sherwin-sattar/soldering-station_V1.1/Hardware/3D view/T12 soldering station V1.1(1).png

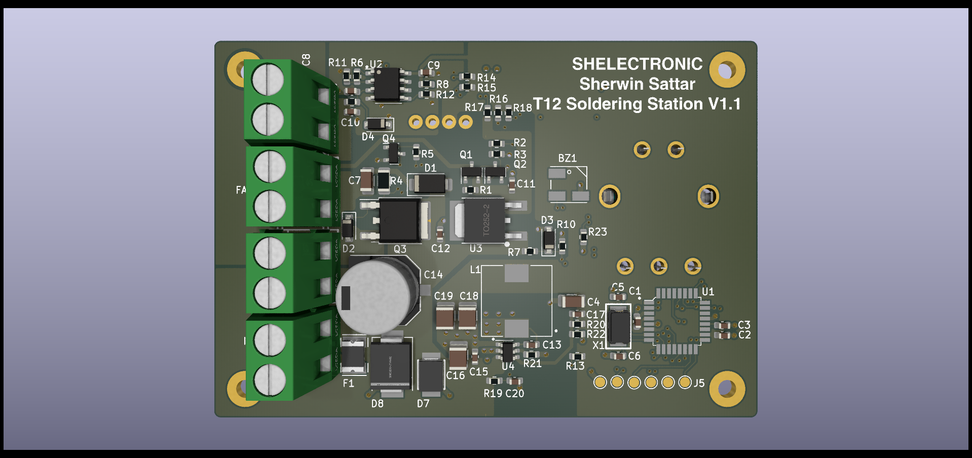
Hardware/3D view/T12 soldering station V1.1(1).png
