sherwin-sattar/soldering-station_V1.1/README.md

# Soldering Station V1.1
## 3D views
T12 soldering station V1 1(1)
T12 soldering station V1 1(2)
