sherwin-sattar/soldering-station_V1.1/Hardware/T12 soldering station.kicad_pcb

## KiCad design Hardware/T12 soldering station.kicad_pcb (2024-11-20)

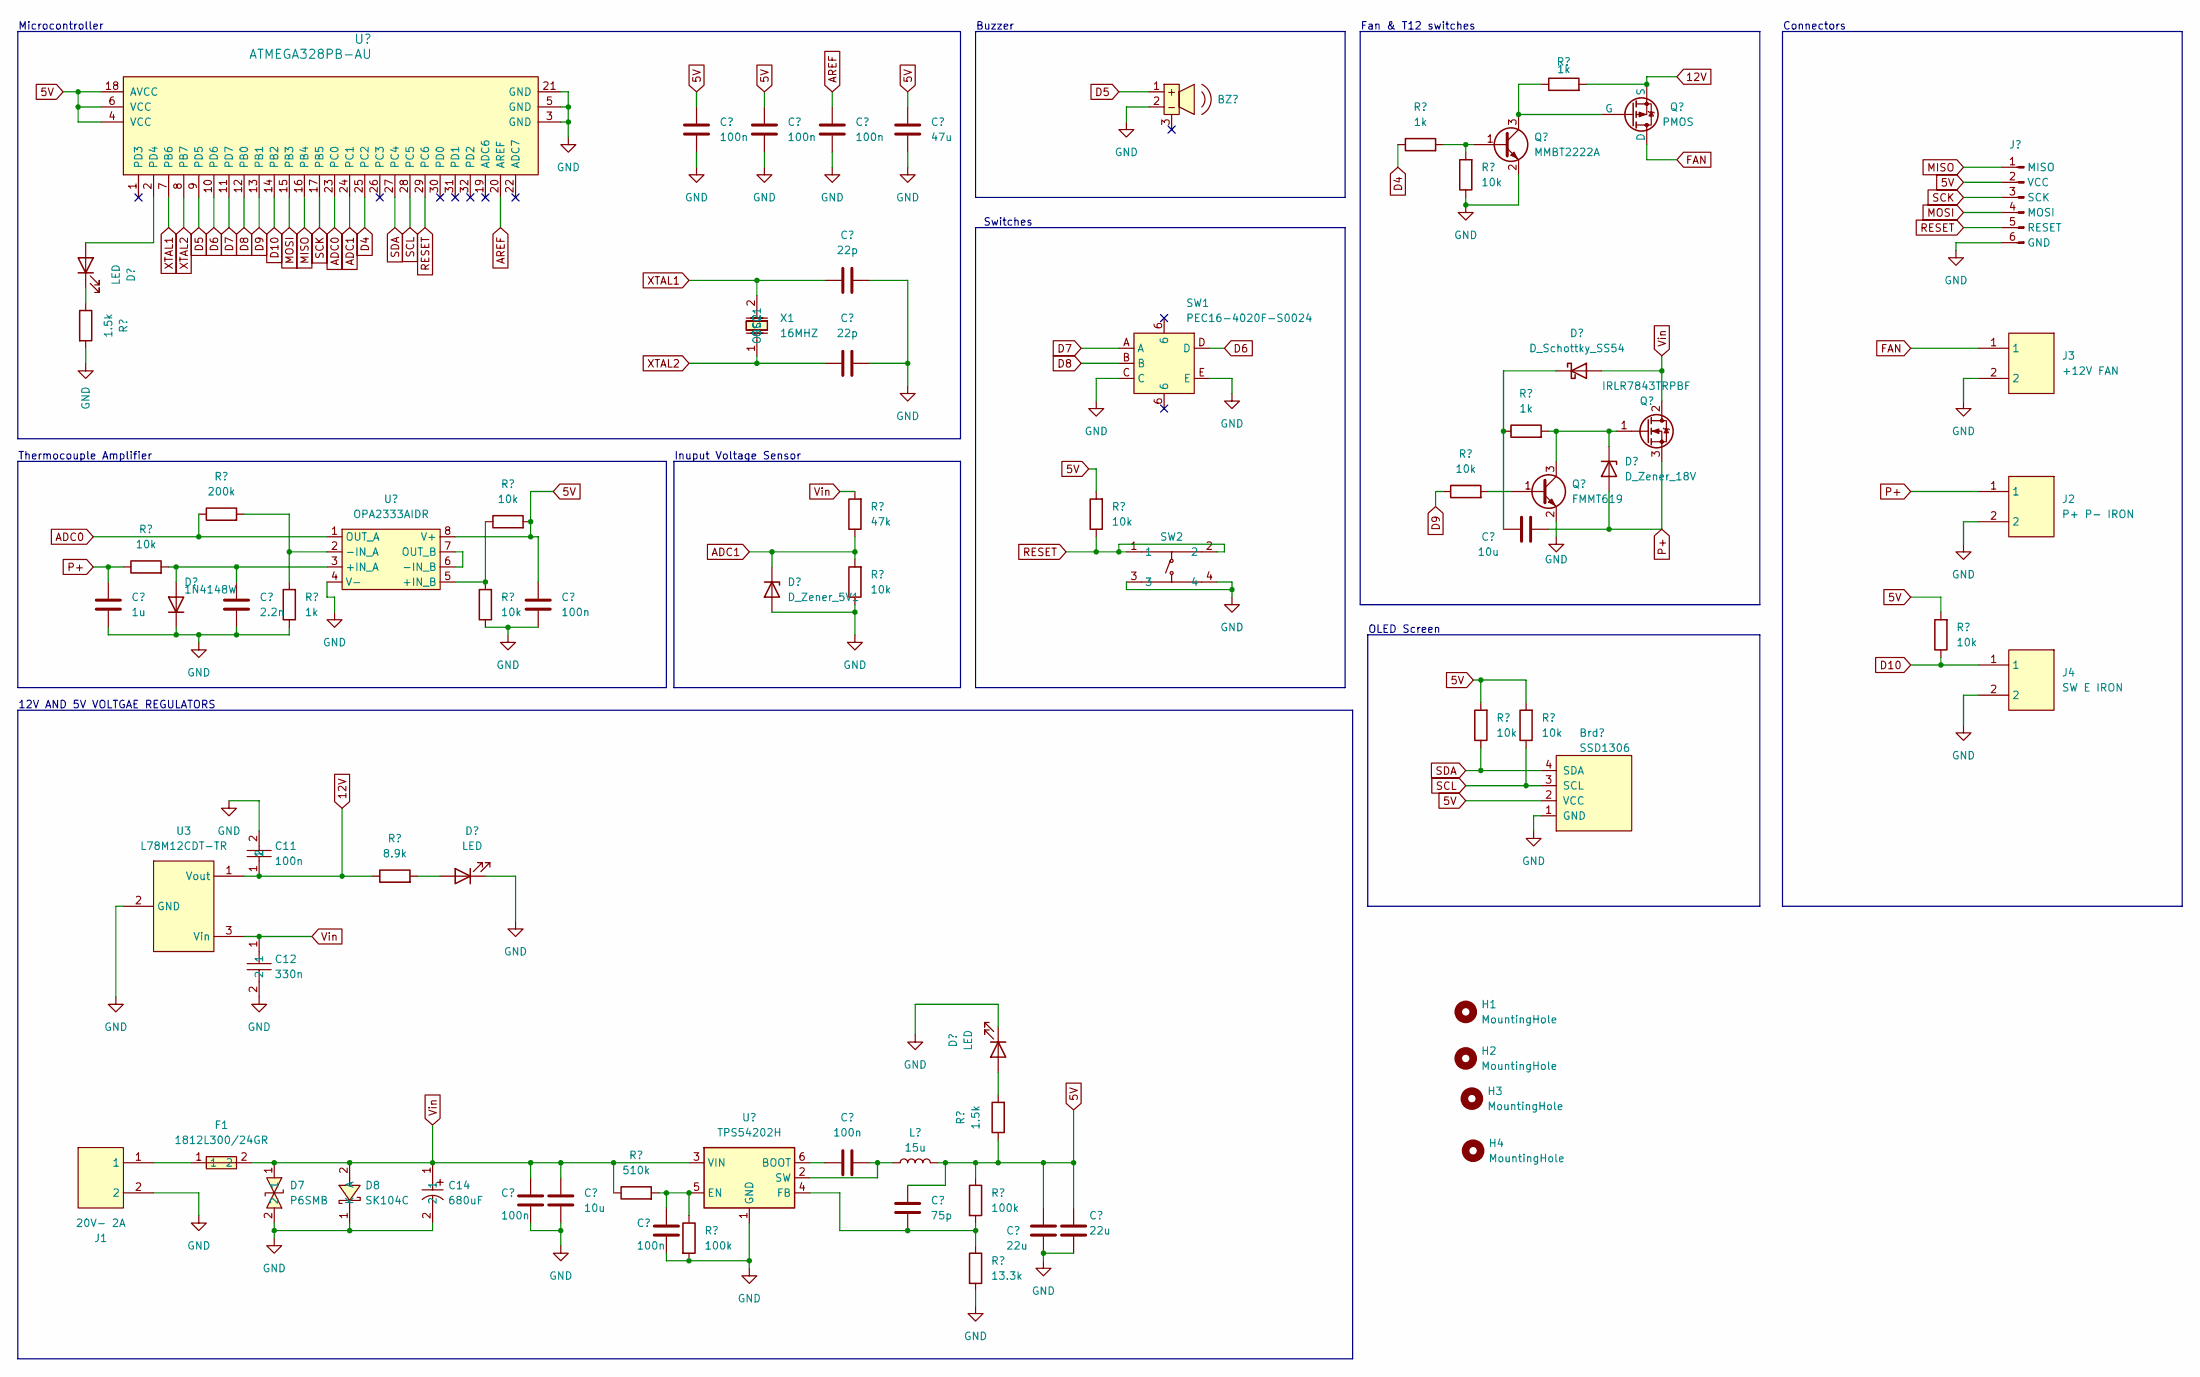
[picture p3: schematic T12 soldering station.kicad_sch, T12 soldering station-V2]

Parts:
BZ1: Buzzer; LCSC PN C95297
C1, C2, C3, C9, C11, C13, C15, C20: 100n; C_0603_1608Metric; LCSC PN C1590
C4: 47u; C_1206_3216Metric; LCSC PN C96123
C5, C6: 22p; C_0603_1608Metric; LCSC PN C1653
C7: 10u; C_1206_3216Metric; LCSC PN C92797
C8: 2.2n; C_0603_1608Metric; LCSC PN C16033
C10: 1u; C_0603_1608Metric; LCSC PN C15849
C12: 330n; C_0603_1608Metric; LCSC PN C694217
C14: 680uF; CAP-SMD_BD10.0-L10.3-W10.3-LS10.9-FD; LCSC PN C2980172
C16: 10u; C_1210_3225Metric; LCSC PN C1952589
C17: 75p; C_0603_1608Metric; LCSC PN C426100
C18, C19: 22u; C_1210_3225Metric; LCSC PN C21397
D1: D_Schottky_SS54; D_SMA; LCSC PN C123946
D2: D_Zener_18V; D_SOD-123; LCSC PN C116111
D3: D_Zener_5V1; D_SOD-123; LCSC PN C81601
D4: 1N4148W; D_SOD-123; LCSC PN C241939
D5, D6, D9: LED; LED_0603_1608Metric; LCSC PN C440519
D7: P6SMB; DO-214AA_L4.4-W3.6-LS5.3-BI; LCSC PN C776247
D8: SK104C; SMC_L6.9-W5.9-LS7.9-RD; LCSC PN C18199211
F1: 1812L300/24GR; F1812; LCSC PN C20627123
H1, H2, H3, H4: MountingHole; MountingHole_2.7mm_M2.5_Pad_TopBottom
J1: 20V- 2A; CONN-TH_2P-P5.00_WJ128V-5.0-2P; LCSC PN C8269
J2: P+ P- IRON; CONN-TH_2P-P5.00_WJ128V-5.0-2P; LCSC PN C8269
J3: +12V FAN; CONN-TH_2P-P5.00_WJ128V-5.0-2P; LCSC PN C8269
J4: SW E IRON; CONN-TH_2P-P5.00_WJ128V-5.0-2P; LCSC PN C8269
J5: ISP_1x6
L1: 15u; L_10.4x10.4_H4.8; LCSC PN C225048
LCD1: SSD1306; oled0.96_4pin; LCSC PN C5248080
Q1: PMOS; SOT-23; LCSC PN C15127
Q2: MMBT2222A; SOT-23; LCSC PN C194252
Q3: IRLR7843TRPBF; TO-252-2; LCSC PN C21988
Q4: FMMT619; SOT-23; LCSC PN C53071
R1, R2, R11: 1k; R_0603_1608Metric; LCSC PN C21190
R3, R5, R8, R9, R10, R12, R13, R14, R15, R16: 10k; R_0603_1608Metric; LCSC PN C25804
R4: 1k; R_1206_3216Metric; LCSC PN C4410
R6: 200k; R_0603_1608Metric; LCSC PN C25811
R7: 47k; R_0603_1608Metric; LCSC PN C25819
R17: 8.9k; R_0603_1608Metric; LCSC PN C5197519
R18, R23: 1.5k; R_0603_1608Metric; LCSC PN C22843
R19: 510k; R_0603_1608Metric; LCSC PN C843959
R20, R21: 100k; R_0603_1608Metric; LCSC PN C844916
R22: 13.3k; R_0603_1608Metric; LCSC PN C844126
SW1: PEC16-4020F-S0024; SW-TH_PEC16-4020F-S0024; LCSC PN C143803
SW2: PTS645SH50SMTR92LFS; KEY-SMD_4P-L6.0-W6.0-P4.50-LS9.0; LCSC PN C221869
U1: ATMEGA328PB-AU; TQFP-32_7x7mm; MPN ATMEGA328P-AU; Digi-Key_PN ATMEGA328P-AU-ND
U2: OPA2333AIDR; SOIC-8_3.9x4.9mm_P1.27mm; LCSC PN C38732
U3: L78M12CDT-TR; TO-252-2_L6.5-W6.1-P4.58-LS10.0-TL; LCSC PN C16424
U4: TPS54202H; SOT-23-6; LCSC PN C527684
X1: 16MHZ; OSC-SMD_L5.0-W3.2; LCSC PN C112572

Connections:
5V: C1.2, C2.2, C4.2, C9.2, C17.1, C18.1, C19.1, J5.2 (VCC), L1.2, LCD1.2 (VCC), R8.2, R13.2, R14.2, R15.2, R16.2, R18.1, R20.1, U1.4 (VCC), U1.6 (VCC), U1.18 (AVCC), U2.8 (V+)
12V: C11.1, Q1.2 (S), R1.2, R17.1, U3.1 (Vout)
ADC0: R6.1, U1.23 (PC0), U2.1 (OUT_A)
ADC1: D3.1 (K), R7.1, R10.2, U1.24 (PC1)
AREF: C3.2, U1.20 (AREF)
D4: R2.1, U1.25 (PC2)
D5: BZ1.1, U1.9 (PD5)
D6: SW1.D, U1.10 (PD6)
D7: SW1.A, U1.11 (PD7)
D8: SW1.B, U1.12 (PB0)
D9: R5.1, U1.13 (PB1)
D10: J4.1, R13.1, U1.14 (PB2)
FAN: J3.1, Q1.3 (D)
GND: BZ1.2, C1.1, C2.1, C3.1, C4.1, C5.1, C6.1, C8.1, C9.1, C10.1, C11.2, C12.2, C14.2, C15.2, C16.2, C18.2, C19.2, C20.2, D3.2 (A), D4.1 (K), D5.1 (K), D6.1 (K), D7.2, D8.1 (K), J1.2, J2.2, J3.2, J4.2, J5.6 (GND), LCD1.1 (GND), Q2.2 (E), Q4.2 (E), R3.1, R10.1, R11.1, R12.1, R21.2, R22.2, R23.2, SW1.C, SW1.E, SW2.3, SW2.4, U1.3 (GND), U1.5 (GND), U1.21 (GND), U2.4 (V-), U3.2 (GND), U4.1 (GND)
MISO: J5.1 (MISO), U1.16 (PB4)
MOSI: J5.4 (MOSI), U1.15 (PB3)
unnamed: C7.1, D1.1 (K), R4.1
unnamed: D2.1 (K), Q3.1 (G), Q4.3 (C), R4.2
unnamed: C8.2, D4.2 (A), R9.2, U2.3 (+IN_A)
unnamed: D5.2 (A), R17.2
unnamed: D6.2 (A), R18.2
unnamed: D9.2 (A), U1.2 (PD4)
unnamed: D9.1 (K), R23.1
unnamed: F1.1, J1.1
unnamed: Q1.1 (G), Q2.3 (C), R1.1
unnamed: Q2.1 (B), R2.2, R3.2
unnamed: Q4.1 (B), R5.2
unnamed: R8.1, R12.2, U2.5 (+IN_B)
unnamed: R6.2, R11.2, U2.2 (-IN_A)
unnamed: U2.6 (-IN_B), U2.7 (OUT_B)
unnamed: C13.1, U4.6 (BOOT)
unnamed: C20.1, R19.2, R21.1, U4.5 (EN)
unnamed: C17.2, R20.2, R22.1, U4.4 (FB)
unnamed: C13.2, L1.1, U4.2 (SW)
P+: C7.2, C10.2, D2.2 (A), J2.1, Q3.3 (S), R9.1
RESET: J5.5 (RESET), R16.1, SW2.1, SW2.2, U1.29 (PC6)
SCK: J5.3 (SCK), U1.17 (PB5)
SCL: LCD1.3 (SCL), R15.1, U1.28 (PC5)
SDA: LCD1.4 (SDA), R14.1, U1.27 (PC4)
Vin: C12.1, C14.1, C15.1, C16.1, D1.2 (A), D7.1, D8.2 (A), F1.2, Q3.2 (D), R7.2, R19.1, U3.3 (Vin), U4.3 (VIN)
XTAL1: C5.2, U1.7 (PB6), X1.2 (OSC2)
XTAL2: C6.2, U1.8 (PB7), X1.1 (OSC1)

Notes on the sheet:
Buzzer
Connectors
Fan & T12 switches
Microcontroller
Thermocouple Amplifier
OLED Screen
Inuput Voltage Sensor
12V AND 5V VOLTGAE REGULATORS
Switches

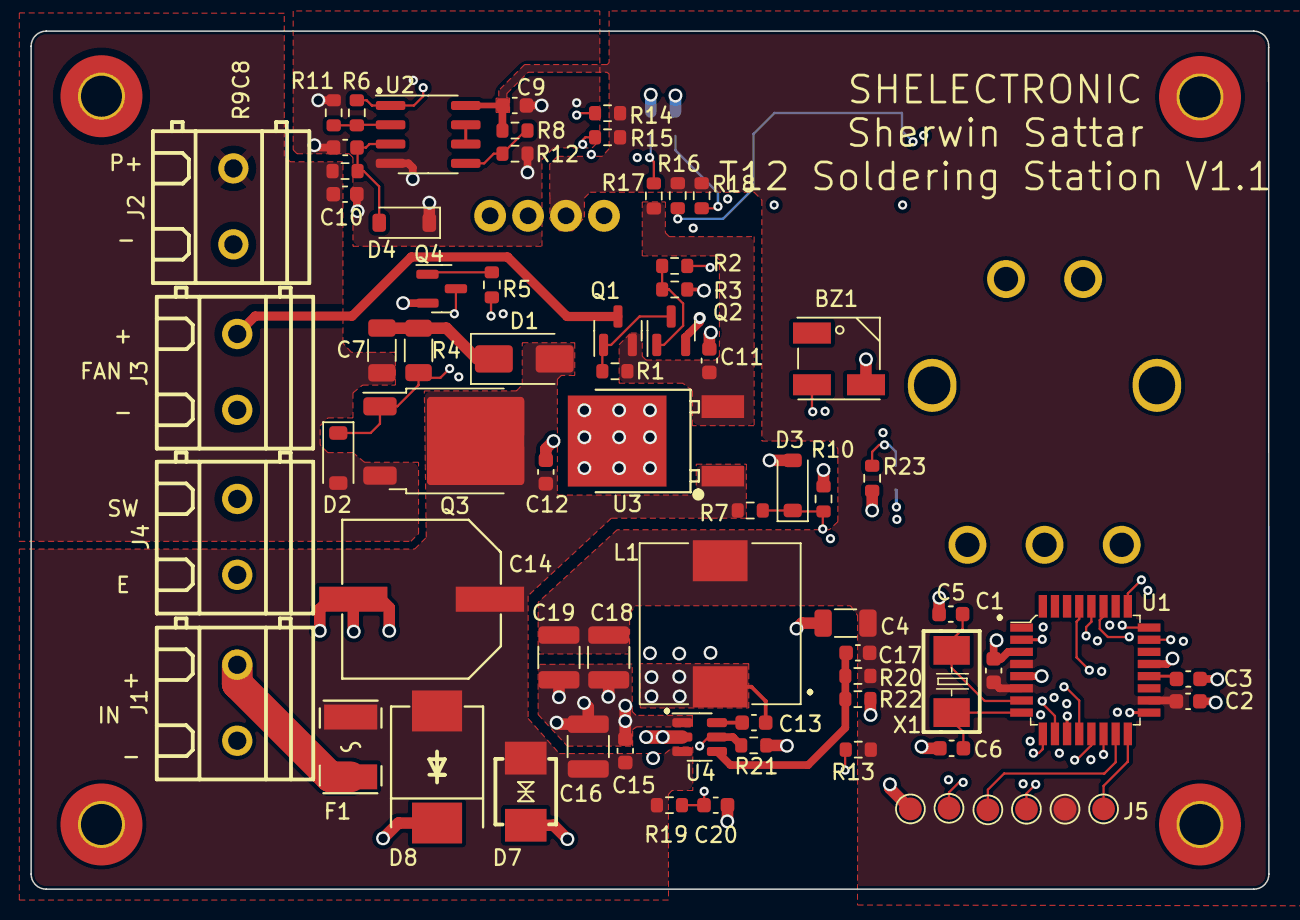
[picture p4: board T12 soldering station.kicad_pcb from above]

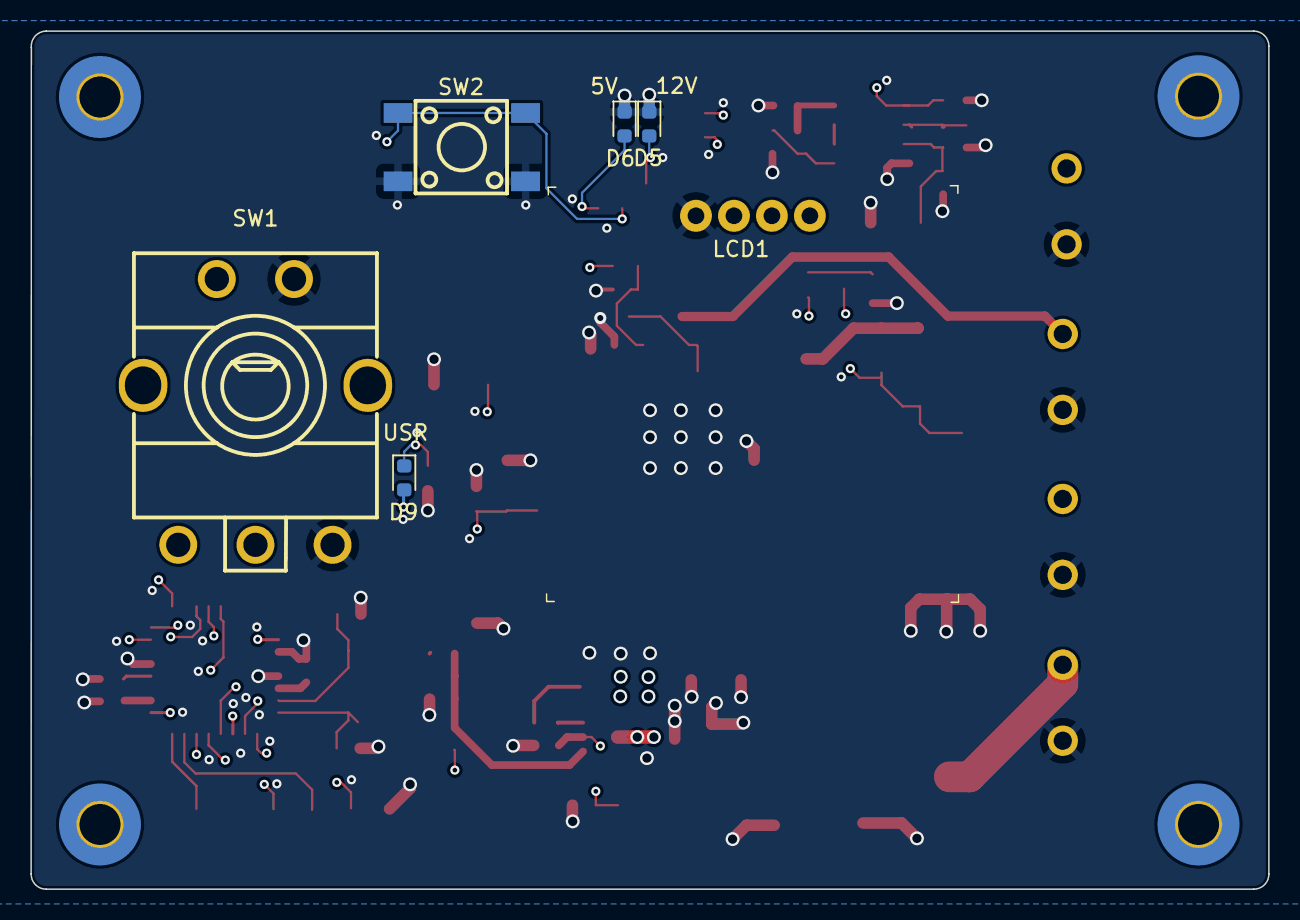
[picture p5: board T12 soldering station.kicad_pcb from below]

Board: 4 copper layers, 81.5 x 56.5 mm, 76 parts (6 on the bottom side), 42 nets.
